roman-petruzela/auticko/modely/uss-6V-holder.stl

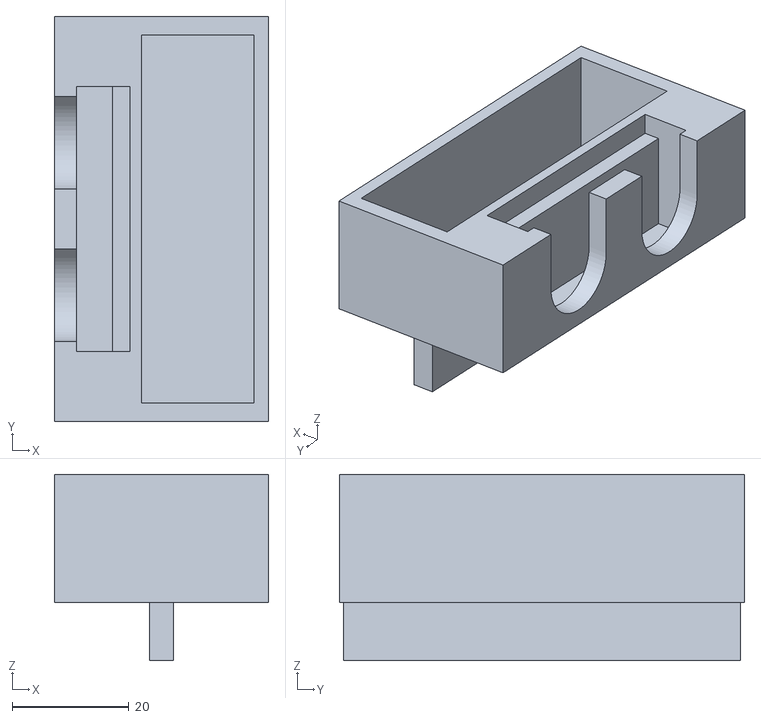
[picture p2: CAD file, 2026-11-05]
modely/uss-6V-holder.stl
36.8 x 69.5 x 32.0
