roman-petruzela/auticko/roboticke_auto/modely/step/USS_holder_front v2.step

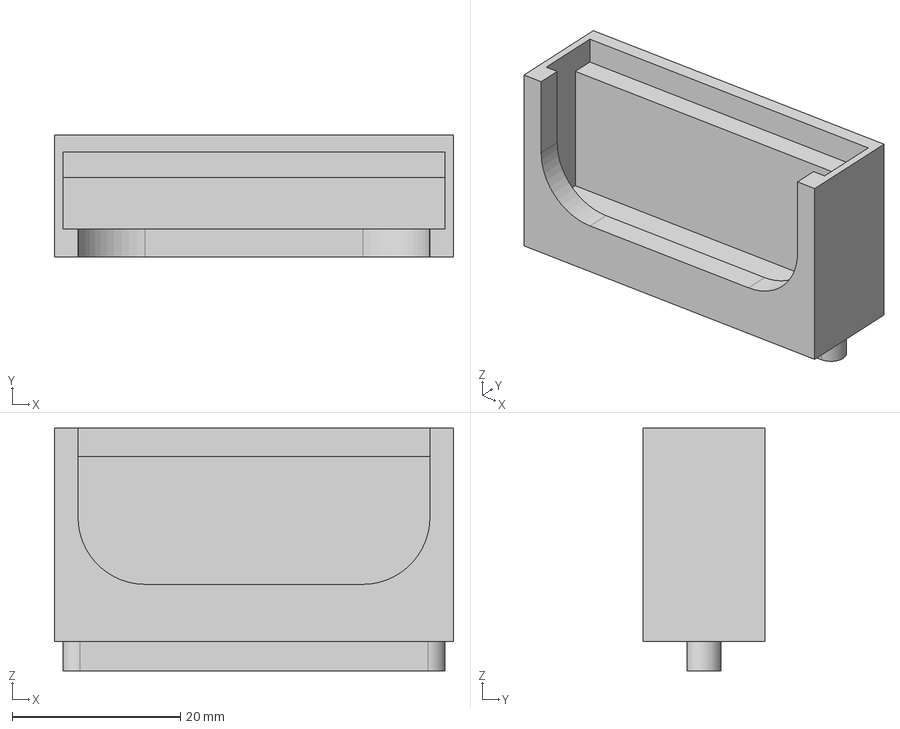
[picture p3: CAD file, 2026-11-05]
roboticke_auto/modely/step/USS_holder_front v2.step
47.5 x 14.5 x 28.9 mm
