roman-petruzela/auticko/roboticke_auto/modely/stl/batter_back_uss_holder v9.stl

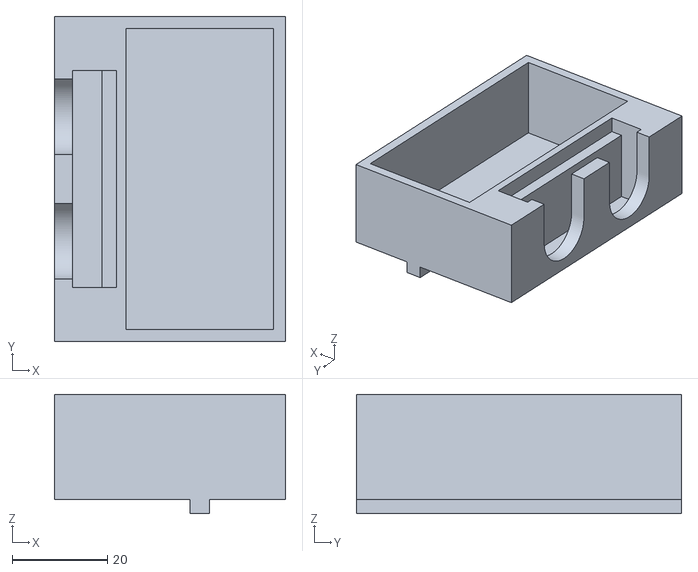
[picture p4: CAD file, 2026-11-05]
roboticke_auto/modely/stl/batter_back_uss_holder v9.stl
48.5 x 68.2 x 25.0
