roman-petruzela/auticko/modely/middlepart.stl

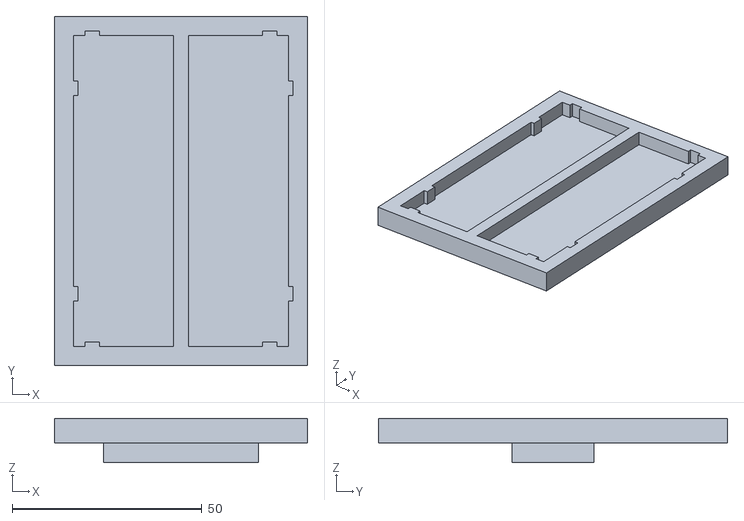
[picture p5: CAD file, 2026-11-05]
modely/middlepart.stl
66.6 x 91.9 x 11.6
