roman-petruzela/auticko/roboticke_auto/modely/stl/offset_holder.stl

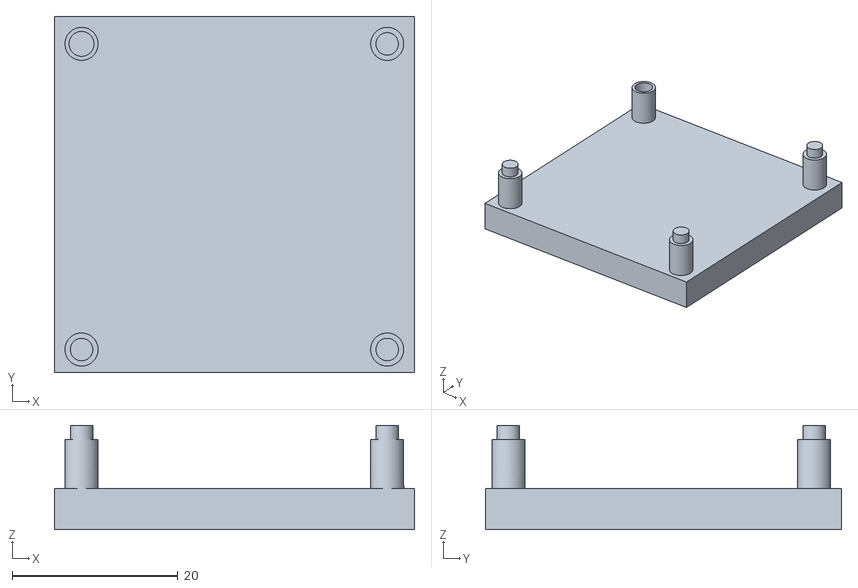
[picture p7: CAD file, 2026-11-05]
roboticke_auto/modely/stl/offset_holder.stl
43.5 x 43.0 x 12.6
