roman-petruzela/auticko/modely/sw-holder-mk2.stl

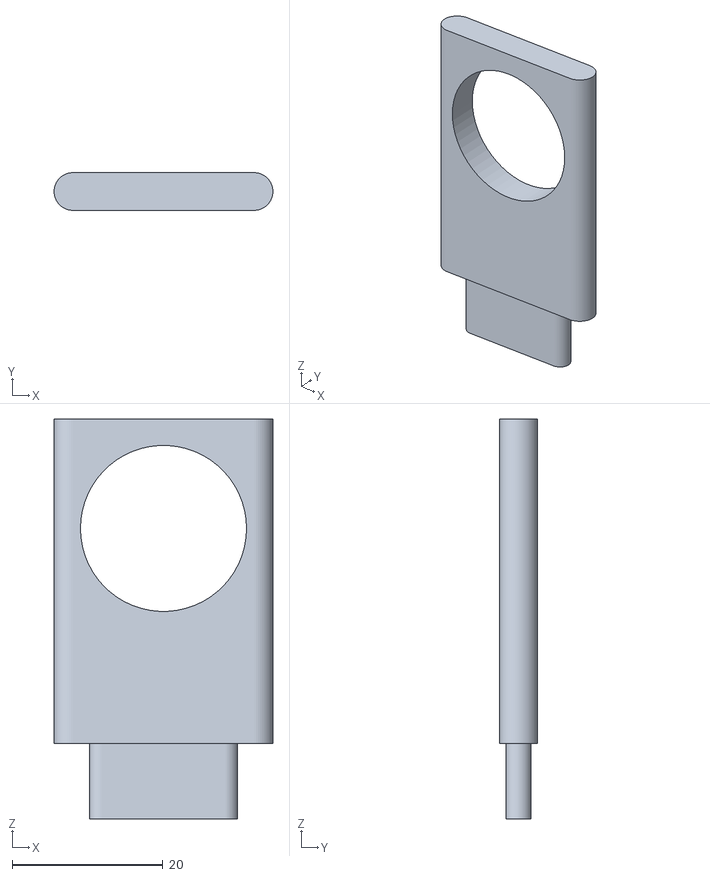
[picture p8: CAD file, 2026-11-05]
modely/sw-holder-mk2.stl
29.0 x 5.00 x 53.0
