roman-petruzela/auticko/roboticke_auto/modely/step/switch_holder v4.step

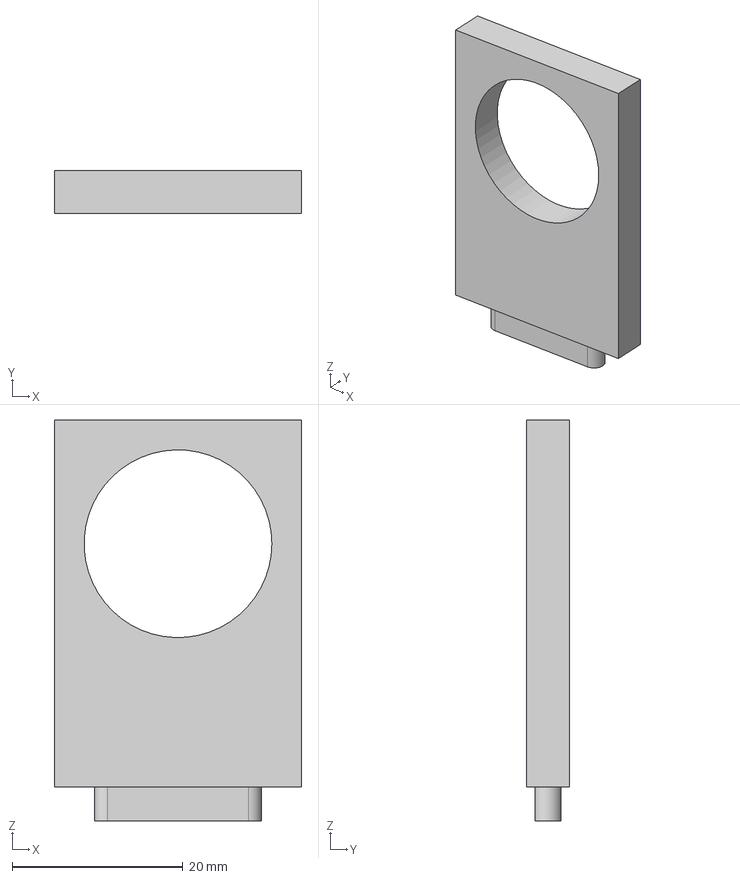
[picture p9: CAD file, 2026-11-05]
roboticke_auto/modely/step/switch_holder v4.step
29.0 x 5.00 x 47.0 mm
