roman-petruzela/auticko/roboticke_auto/modely/step/holder.step

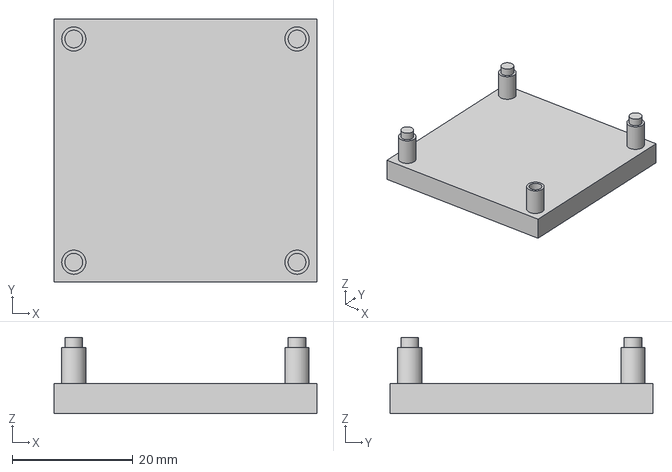
[picture p10: CAD file, 2026-11-05]
roboticke_auto/modely/step/holder.step
43.5 x 43.5 x 12.6 mm
