roman-petruzela/auticko/roboticke_auto/modely/step/holder_offset.step

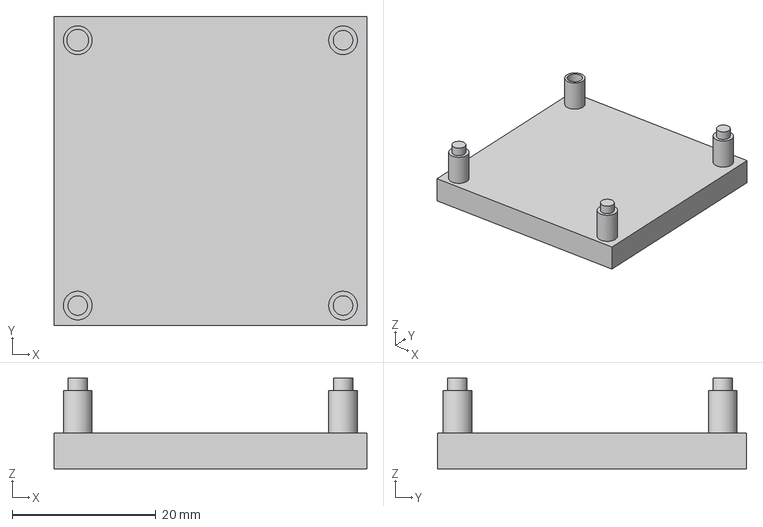
[picture p11: CAD file, 2026-11-05]
roboticke_auto/modely/step/holder_offset.step
43.5 x 43.0 x 12.6 mm
