roman-petruzela/auticko/roboticke_auto/modely/step/Component1.step

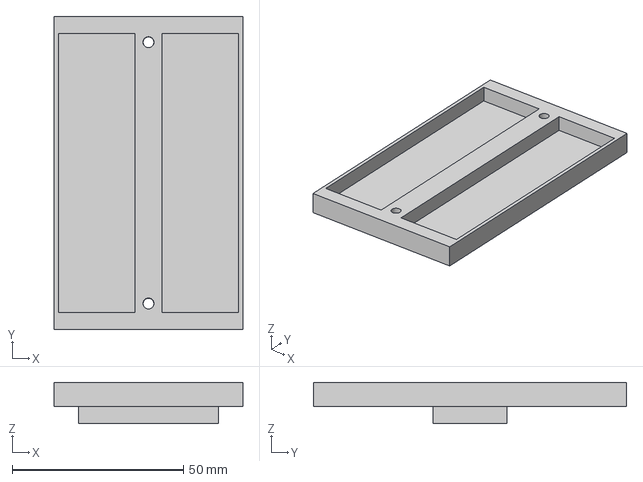
[picture p12: CAD file, 2026-11-05]
roboticke_auto/modely/step/Component1.step
55.0 x 91.3 x 12.0 mm
