roman-petruzela/auticko/(list of files, cad)

Other CAD files:
roboticke_auto/modely/step/battery_back_uss_holder v9.step
roboticke_auto/modely/stl/Component1.stl
roboticke_auto/modely/stl/USS_holder_front v2.stl
roboticke_auto/modely/stl/USS_holder_side v4.stl
roboticke_auto/modely/stl/holder.stl
roboticke_auto/modely/stl/switch_holder v4.stl
