roman-petruzela/auticko/(commit log)

2026-11-05 chore(roboticke_auto): add original car sketch and 3D models, add gitignore
    [Component1.step, Component1.stl, USS_holder_front v2.step, USS_holder_front v2.stl, USS_holder_side v4.step, USS_holder_side v4.stl, batter_back_uss_holder v9.stl, battery_back_uss_holder v9.step]
2026-11-05 feat(test): add motor test sketch
2026-11-05 docs(readme): add project description, hardware and wiring
2026-11-05 chore(roboticke_auto): fix typo in dir name
    [Component1.step, Component1.stl, USS_holder_front v2.step, USS_holder_front v2.stl, USS_holder_side v4.step, USS_holder_side v4.stl, batter_back_uss_holder v9.stl, battery_back_uss_holder v9.step]
2026-11-05 feat(modely): add own 3D models and car photo
    [middlepart.stl, sw-holder-mk2.stl, uss-6V-holder.stl]
2026-11-05 docs(readme): add project description, hardware, wiring, photo and models
2026-11-06 refactor(test): move motor test into its own sketch folder
2026-11-06 fix(auticko): update motor pins to new wiring, add PWM and direction invert
    [auticko.ino]
2026-11-06 refactor(firmware): split auticko.ino into motory and api tabs
2026-11-06 chore(tests): rename auticko_zaloha to test_wifi, add motors test to /test
